DaveBben/esp32_digital_mom_sign/README.md

# ESP32 Digital Mom Sign

A custom digital photo frame that I built my mom for mother's day. It uses [AWS infrastructure](https://github.com/DaveBben/digital_mom_sign_cloud_infrastructure/tree/main) to display photos from an S3 bucket.

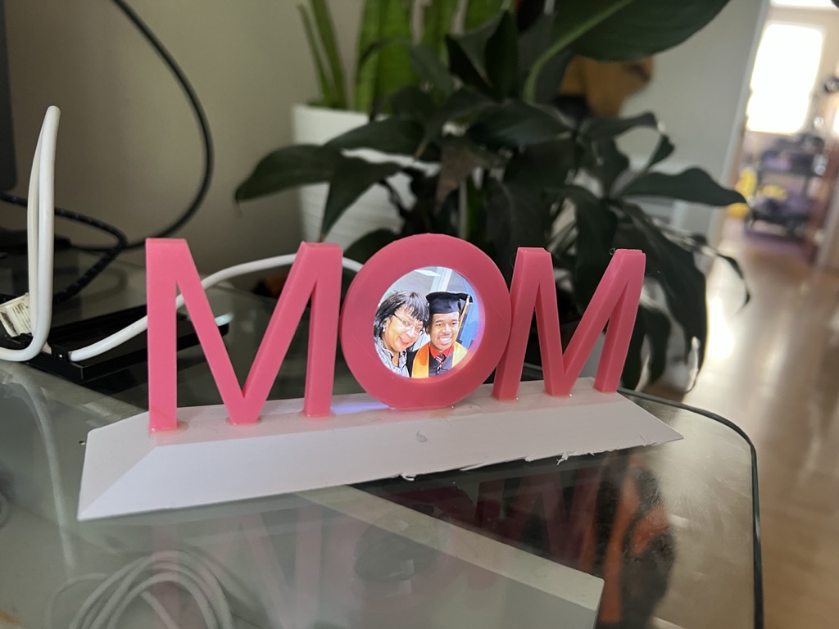
[picture p1: demo_image.jpeg]
Esp32 Photo Frame
