DaveBben/esp32_digital_mom_sign/hardware/3d_view_pcb.png

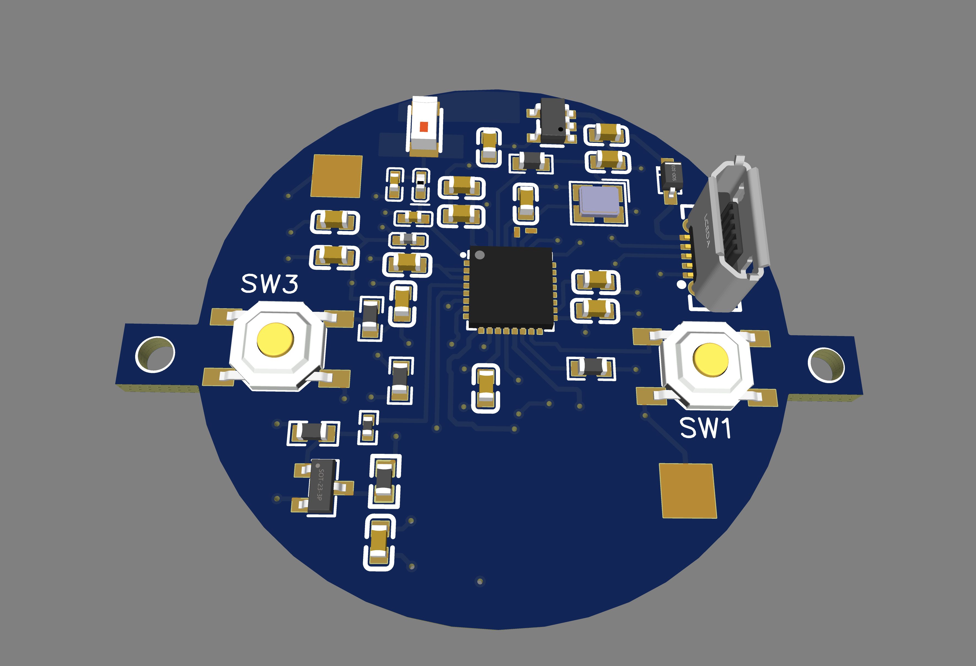
hardware/3d_view_pcb.png
