DaveBben/esp32_digital_mom_sign/hardware/BOM_PCB_Digital_Mom_sign.csv

ID | Name | Designator | Footprint | Quantity | Manufacturer Part | Manufacturer | Supplier | Supplier Part | Price
1 | TS-1187A-B-A-B | SW1,SW3 | SW-SMD_4P-L5.1-W5.1-P3.70-LS6.5-TL-2 | 2 | TS-1187A-B-A-B | XKB Connectivity(中国星坤) | LCSC | C318884 | 0.016
2 | U-D-M5DS-Y-3 | USB2 | MICRO-USB-SMD_U-D-M5DS-Y-3 | 1 | U-D-M5DS-Y-3 | 韩国韩荣 | LCSC | C283543 | 0.34
3 | 2.7pF | C2 | C0402 | 1 | 0402CG2R7C500NT | FH(风华) | LCSC | C1561 | 0.001
4 | 2pF | C3 | C0402 | 1 | 0402CG2R0C500NT | FH(风华) | LCSC | C1558 | 0.001
5 | 2.7nH | L2 | L0402-RD | 1 | MLG1005S2N7BTD25 | TDK | LCSC | C360711 | 0.015
6 | 2450AT18A100E | AE1 | ANT-SMD_L3.2-W1.6 | 1 | 2450AT18A100E | JOHANSON(约翰逊) | LCSC | C89334 | 0.447
7 | 10nF | C1 | C0603 | 1 | 0603B103K500NT | FH(风华) | LCSC | C57112 | 0.003
8 | 1uF | C6,C9,C22,C23 | C0603 | 4 | CL10A105KB8NNNC | SAMSUNG(三星) | LCSC | C15849 | 0.006
9 | 100nF | C15,C16,C17,C18 | C0603 | 4 | CC0603KRX7R9BB104 | YAGEO(国巨) | LCSC | C14663 | 0.002
10 | 10uF | C19,C25,C26 | C0603 | 3 | CL10A106MA8NRNC | SAMSUNG(三星) | LCSC | C96446 | 0.021
11 | 12pF | C27,C28 | C0603 | 2 | CC0603JRNPO9BN120 | YAGEO | LCSC | C107034 | 0.003
12 | 1N5819WS | D4 | SOD-323_L1.8-W1.3-LS2.5-RD | 1 | 1N5819WS | Hottech(合科泰) | LCSC | C191023 | 0.013
13 | 2nH | L1 | L0402 | 1 | SDCL1005C2N0STDF | Sunlord | LCSC | C43365 | 0.003
14 | 10K | R2,R10,R11,R14 | R0603 | 4 | RC0603JR-0710KL | YAGEO(国巨) | LCSC | C99198 | 0.001
15 | 0Ω | R4 | R0603 | 1 | 0603WAF0000T5E | UNI-ROYAL(厚声) | LCSC | C21189 | 0.001
16 | 10Ω | R26 | R0603 | 1 | 0603WAF100JT5E | UniOhm | LCSC | C22859 | 0.001
17 | ESP32-C3FH4 | U3 | QFN-32_L5.0-W5.0-P0.50-TL-EP3.7 | 1 | ESP32-C3FH4 | ESPRESSIF 乐鑫 | LCSC | C2858491 | 2.105
18 | TPAP2112K-3.3TRG1 | U8 | SOT-23-5_L2.9-W1.6-P0.95-LS2.8-BR | 1 | TPAP2112K-3.3TRG1 | TECH PUBLIC(台舟) | LCSC | C3021085 | 0.103
19 | 40MHz | X3 | CRYSTAL-SMD_4P-L2.5-W2.0-BL | 1 | Q24FA20H0020900 | EPSON(爱普生) | LCSC | C255973 | 0.244
20 | MMBT2222A_C8512 | Q3 | SOT-23-3_L2.9-W1.3-P1.90-LS2.4-BR | 1 | MMBT2222A | CJ | LCSC | C8512 | 0.021
21 | 1kΩ | R1 | R0402 | 1 | 0402WGF1001TCE | UniOhm | LCSC | C11702 | 0.001
22 | GC9A01_ROUND_1.28 COPY | U1 | GC9A01_ROUND_1.28 | 1
