DaveBben/esp32_digital_mom_sign/hardware/letter_m.stl

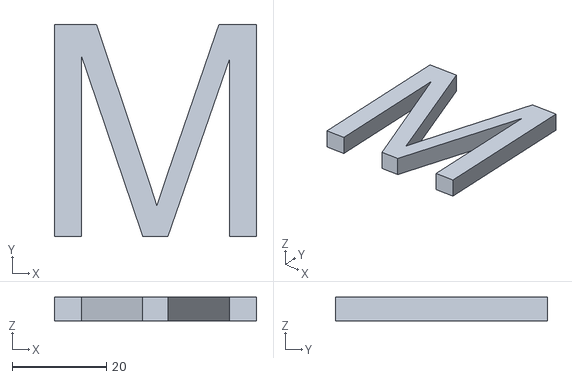
[picture p3: CAD file, 2023-08-26]
hardware/letter_m.stl
42.9 x 45.0 x 5.00
