DaveBben/esp32_digital_mom_sign/hardware/base_plate.stl

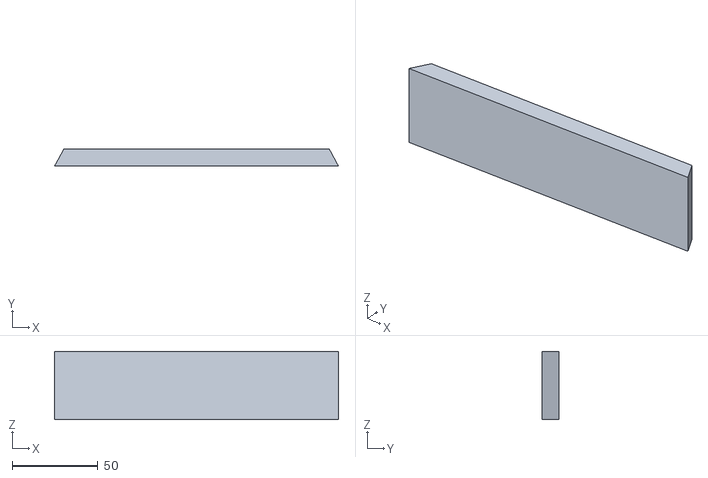
[picture p4: CAD file, 2023-08-26]
hardware/base_plate.stl
166.0 x 10.0 x 40.0
