DaveBben/esp32_digital_mom_sign/hardware/letter_o.stl

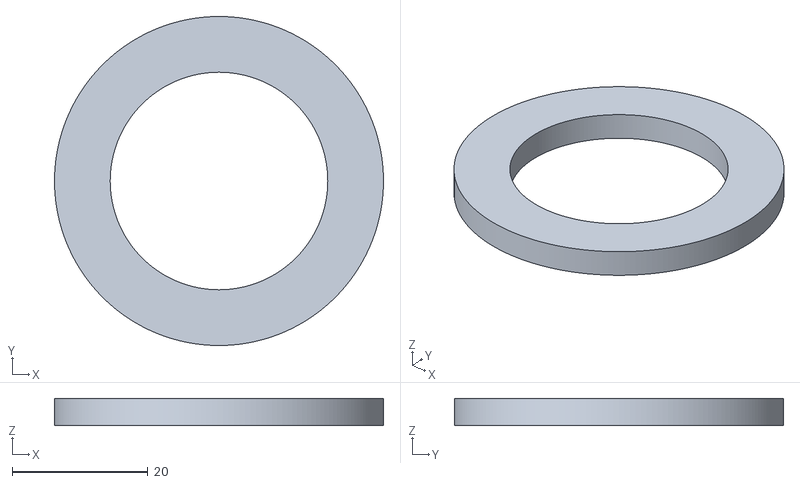
[picture p5: CAD file, 2023-08-26]
hardware/letter_o.stl
48.4 x 48.4 x 4.00
