DaveBben/esp32_digital_mom_sign/hardware/Schematic_Digital Mom_sign.pdf

USB Power | Regulation

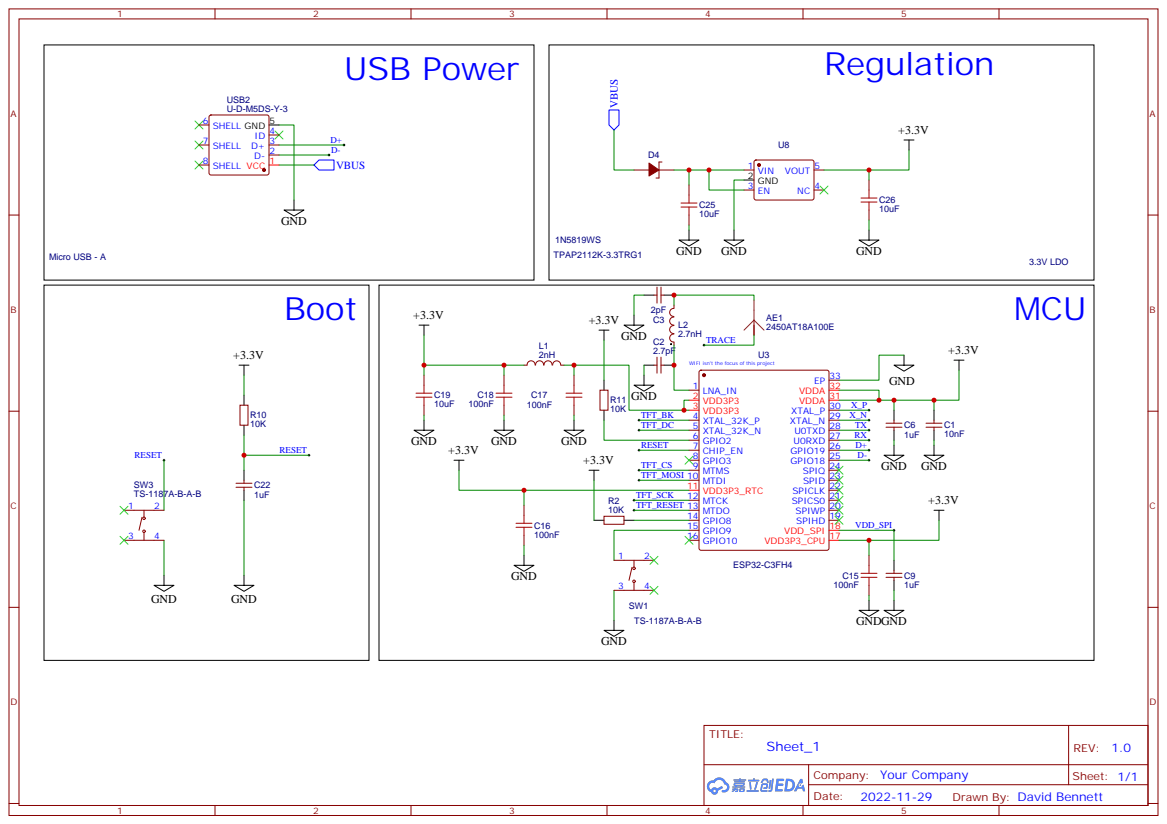
[picture p6: page 1]

Drawn By: David Bennett

# LCD Display Crystal

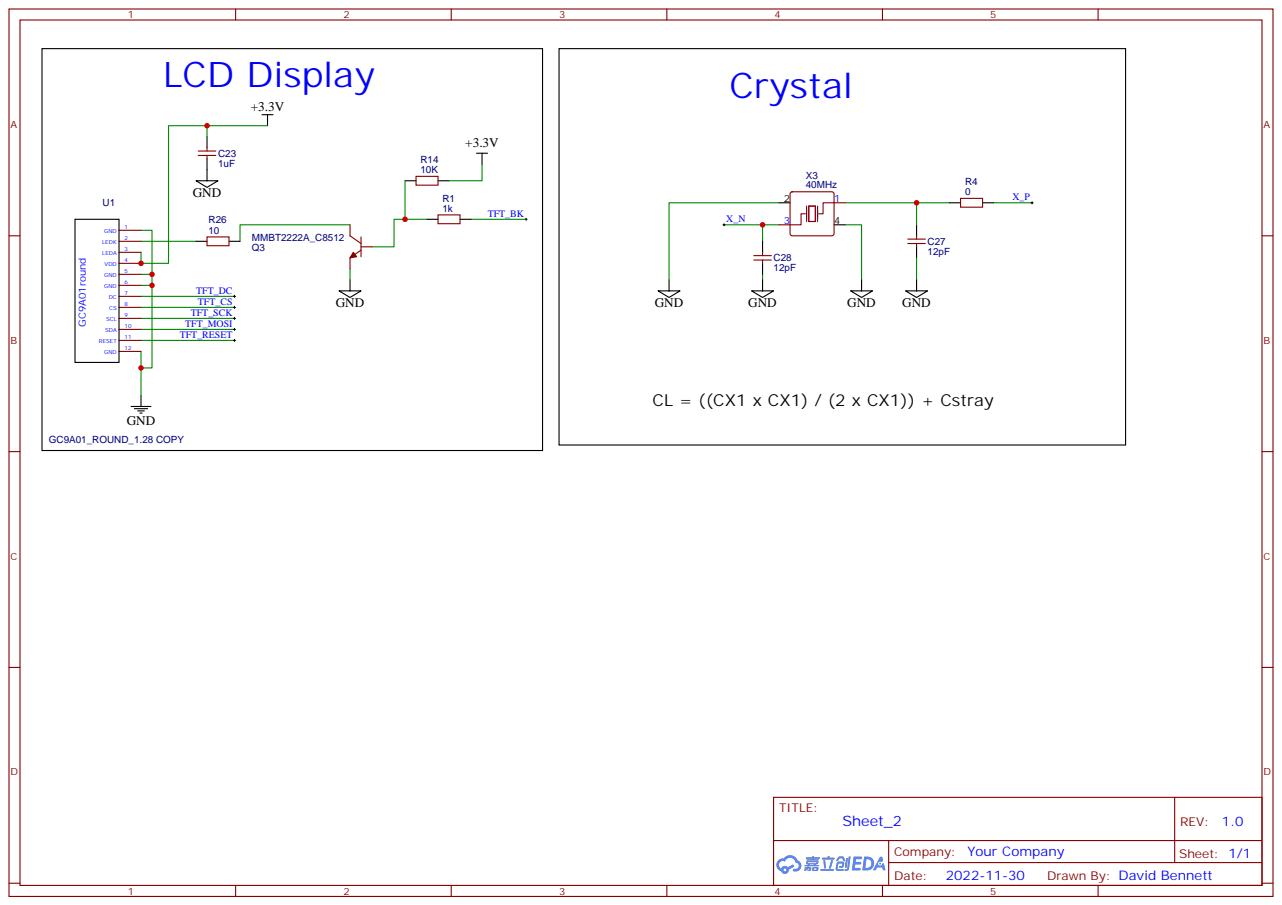
[picture p7: page 2]

Drawn By: David Bennett
