DaveBben/esp32_digital_mom_sign/hardware/PCB_Digital_Mom_sign.pdf

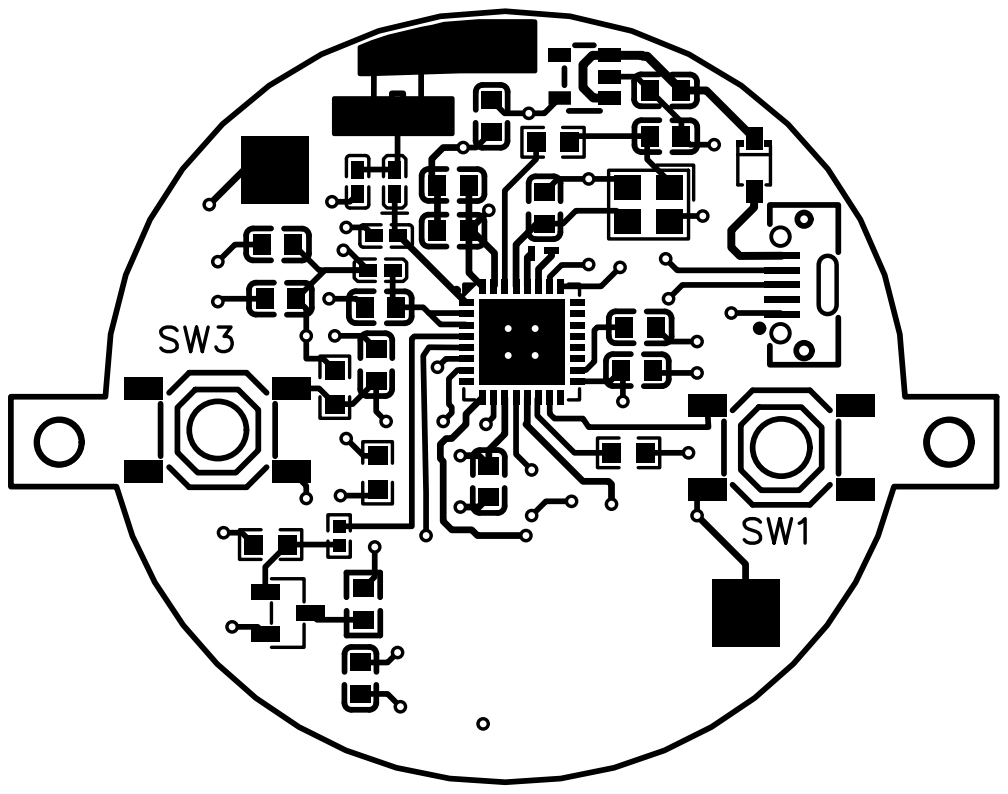
[picture p8: page 1]
